ctolleson/ble-parasite/(list of files, drawings)

Other design files:
kicad-large-smt-nrf52840/output/pcb_quality_gate.json
kicad-large-smt-nrf52840/output/schematic_quality_gate.json
