ctolleson/ble-parasite/kicad-large-smt-nrf52840/parasite.kicad_pcb

## KiCad design kicad-large-smt-nrf52840/parasite.kicad_pcb (2026-10-23)

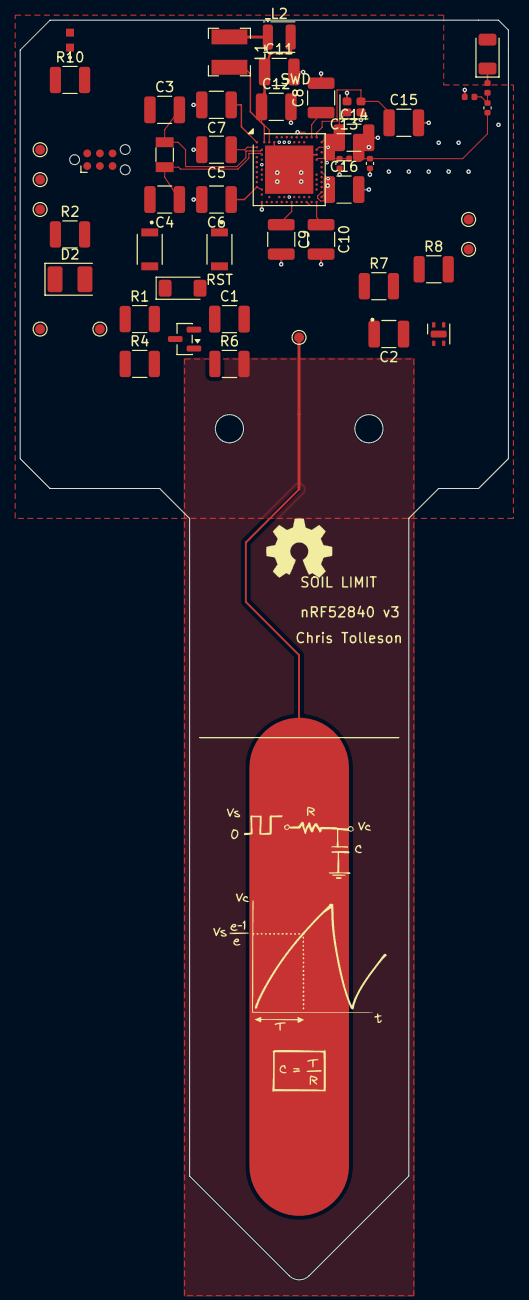
[picture p3: board parasite.kicad_pcb from above]

Board: 4 copper layers, 49.0 x 126.4 mm, 53 parts (1 on the bottom side), 31 nets.

Parts:
AE1: 2450AT18A0100001E; Johanson_2450AT18x100
BT1: Battery_Cell; BatteryHolder_Keystone_1060_NoBodySilk
C1: 1n; C_1210_3225Metric
C2, C5, C8, C9, C10: 100n; C_1210_3225Metric
C3, C4, C14, C15: 12p; C_1210_3225Metric
C6: 4.7u; C_1210_3225Metric
C7, C11: 1u; C_1210_3225Metric
C12: 47n; C_1210_3225Metric
C13: 100p; C_1210_3225Metric
C16: 820p; C_1210_3225Metric
C17: 0.8p; C_0402_1005Metric
C18: 0.5p; C_0402_1005Metric
C19: 1p; C_0402_1005Metric
D1: LL4148; D_MiniMELF
D2: LED; LED_PLCC-2_3.4x3.0mm_KA
J1: TC2030-SWD; Tag-Connect_TC2030-IDC-NL_2x03_P1.27mm_Vertical
L1: 10u; L_Bourns-SRN4018
L2: 15n; L_Coilcraft_1008HQ_2520Metric
L3: 4.7n; L_0402_1005Metric
L4: 2.7n; L_0402_1005Metric
L5: 3.9n; L_0402_1005Metric
Q1: MMBT3906; SOT-23
Q4: Q_Photo_NPN; TR8
R1, R4, R7, R8: 10k; R_1210_3225Metric
R2: 1k; R_1210_3225Metric
R6: 1M; R_1210_3225Metric
R10: 470; R_1210_3225Metric
RST1: B3U-1000P; SW_B3U-1000P
SW1: B3U-1000P; SW_B3U-1000P
TP1: SWDIO; TestPoint_Pad_D1.0mm
TP2: SWDCLK; TestPoint_Pad_D1.0mm
TP3: GND; TestPoint_Pad_D1.0mm
TP4: RST; TestPoint_Pad_D1.0mm
TP5: CPARA; TestPoint_Pad_D1.0mm
TP6: PWM; TestPoint_Pad_D1.0mm
TP7: +3V0; TestPoint_Pad_D1.0mm
TP8: 0.10; TestPoint_Pad_D1.0mm
TP9: SOIL_ELECTRODE; Soil_Electrode_Endpoint_Covered
U1: nRF52840-QIAA; Nordic_AQFN-73-1EP_7x7mm_P0.5mm
U2: SHTC3; Sensirion_DFN-4-1EP_2x2mm_P1mm_EP0.7x1.6mm
Y1: 32.768kHz; Crystal_SMD_3215-2Pin_3.2x1.5mm
Y2: 32MHz; Crystal_SMD_2016-4Pin_2.0x1.6mm

Connections:
0.10: TP8.1 (1_1), U1.J24 (NFC2/P0.10)
+3V0: BT1.1 (+), C2.1, C6.1, C7.1, C8.1, C9.1, C10.1, J1.1, R7.2, R8.1, TP7.1 (1_1), U1.A22 (VDD), U1.AD14 (VDD), U1.AD23 (VDD), U1.B1 (VDD), U1.W1 (VDD), U1.Y2 (VDDH), U2.1 (VDD)
ANT_FEED: AE1.1 (FEED_1), L5.2
ANT_TUNE: C19.2, L4.1, L5.1
BTN1: SW1.1, U1.B9 (AIN6/P0.30)
CPARA: D1.2 (A), Q1.2 (E), R1.2, TP5.1 (1_1), TP9.1 (1_1)
DCC: L1.1, U1.B3 (DCC)
DEC1: C5.1, U1.C1 (DEC1)
DEC3: C13.1, U1.D23 (DEC3)
DEC4_6: C11.1, C12.1, L2.2, U1.B5 (DEC4), U1.E24 (DEC6)
DEC5: C16.1, U1.N24 (DEC5)
GND: BT1.2 (-), C1.2, C2.2, C3.1, C4.2, C5.2, C6.2, C7.2, C8.2, C9.2, C10.2, C11.2, C12.2, C13.2, C14.2, C15.2, C16.2, C17.2, C18.2, D2.1 (K), J1.5, L4.2, Q1.3 (C), R6.2, R10.1, RST1.2, SW1.2, TP3.1 (1_1), U1.AD2 (VBUS), U1.B7 (VSS), U1.EP (VSS), U1.F23 (VSS_PA), U2.4 (VSS), Y2.2 (G), Y2.4 (G)
LED: R2.2, U1.B11 (AIN4/P0.28)
unnamed: D2.2 (A), R2.1
unnamed: L1.2, L2.1
unnamed: Q1.1 (B), R4.1
PHOTO_OUT: Q4.2 (E), R10.2, U1.A12 (AIN0/P0.02)
PHOTO_V: Q4.1 (C), U1.A10 (AIN5/P0.29)
PWM: R1.1, R4.2, TP6.1 (1_1), U1.K2 (AIN3/P0.05)
RF_50: C18.1, C19.1, L3.2
RF_SOC: C17.1, L3.1, U1.H23 (ANT)
RST: J1.3, RST1.1, TP4.1 (1_1), U1.AC13 (P0.18/~RESET)
SCL: R8.2, U1.AD8 (P0.13), U2.2 (SCL)
SDA: R7.1, U1.AD20 (P0.24), U2.3 (SDA)
SENS_OUT: C1.1, D1.1 (K), R6.1, U1.B13 (AIN1/P0.03)
SWDCLK: J1.4, TP2.1 (1_1), U1.AA24 (SWDCLK)
SWDIO: J1.2, TP1.1 (1_1), U1.AC24 (SWDIO)
XC1: C14.1, U1.B24 (XC1), Y2.1
XC2: C15.1, U1.A23 (XC2), Y2.3
XL1: C3.2, U1.D2 (XL1/P0.00), Y1.2
XL2: C4.1, U1.F2 (XL2/P0.01), Y1.1
