ctolleson/ble-parasite/(commit log)

2026-02-13 Added a copy of the KiCAD project to change the circuit board.
    [parasite-B_Cu.gbr, parasite-B_Mask.gbr, parasite-B_Paste.gbr, parasite-B_Silkscreen.gbr, parasite-Edge_Cuts.gbr, parasite-F_Cu.gbr, parasite-F_Mask.gbr, parasite-F_Paste.gbr]
2026-02-13 Created a new KiCad project and renamed the project, put it in a new folder.
    [kicad-experimental-B_Cu.gbr, kicad-experimental-B_Mask.gbr, kicad-experimental-B_Paste.gbr, kicad-experimental-B_Silkscreen.gbr, kicad-experimental-Edge_Cuts.gbr, kicad-experimental-F_Cu.gbr, kicad-experimental-F_Mask.gbr, kicad-experimental-F_Paste.gbr]
2026-02-13 removed unused kicad "experimental" project.
    [parasite-B_Cu.gbr, parasite-B_Mask.gbr, parasite-B_Paste.gbr, parasite-B_Silkscreen.gbr, parasite-Edge_Cuts.gbr, parasite-F_Cu.gbr, parasite-F_Mask.gbr, parasite-F_Paste.gbr]
