ctolleson/ble-parasite/(notices)

Notices in the files:
kicad-large-smt-nrf52840/parasite.kicad_pcb:
Derived from rbaron/b-parasite; hardware CC BY-SA 4.0
